groo030/DGIST-internship-2026/python/requirements-haptic.txt

pyserial>=3.5
bleak
bleak-retry-connector
anthropic
python-dotenv
Pillow
numpy
