groo030/DGIST-internship-2026/housing/housing_peltier_30_closure2_v1.stl

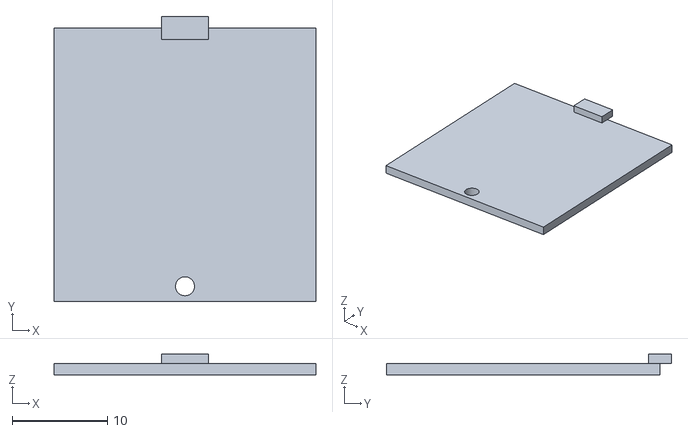
[picture p1: CAD file, 2026-10-23]
housing/housing_peltier_30_closure2_v1.stl
27.6 x 30.0 x 2.20
