groo030/DGIST-internship-2026/housing/housing_peltier_30_box_v1.stl

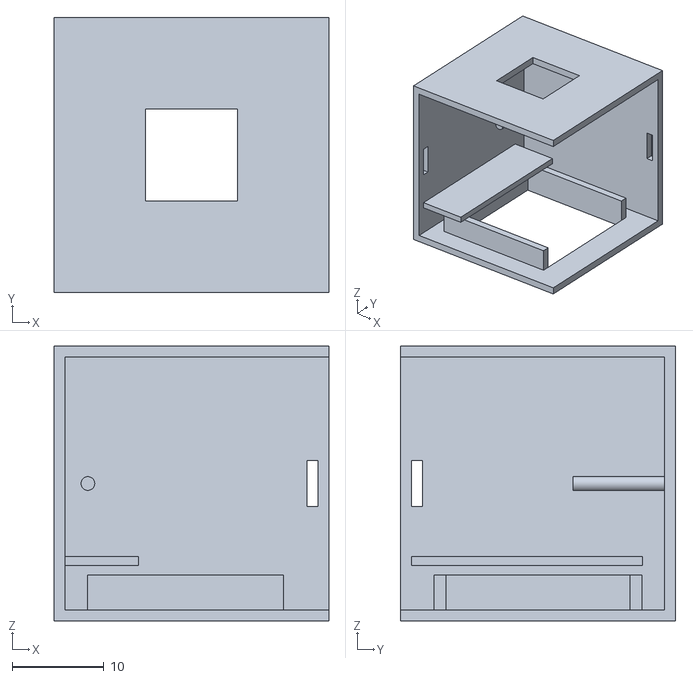
[picture p2: CAD file, 2026-10-23]
housing/housing_peltier_30_box_v1.stl
30.0 x 30.0 x 30.0
