groo030/DGIST-internship-2026/housing/housing_peltier_30_closure1_v1.stl

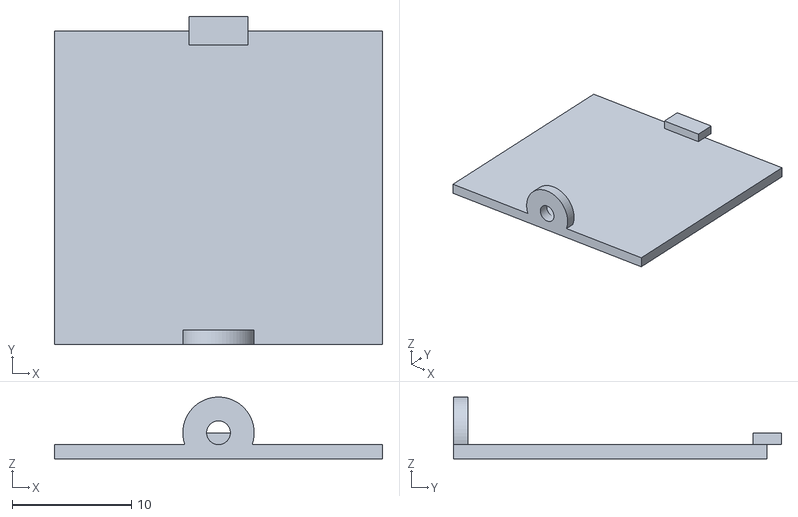
[picture p3: CAD file, 2026-10-23]
housing/housing_peltier_30_closure1_v1.stl
27.6 x 27.6 x 5.20
