groo030/DGIST-internship-2026/housing/housing_erm_box_v2.stl

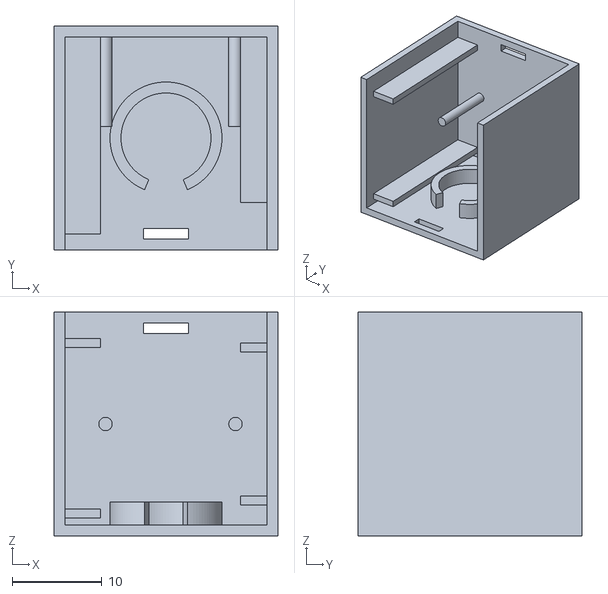
[picture p4: CAD file, 2026-10-23]
housing/housing_erm_box_v2.stl
25.0 x 25.0 x 25.0
