groo030/DGIST-internship-2026/housing/housing_erm_closure1_v2.stl

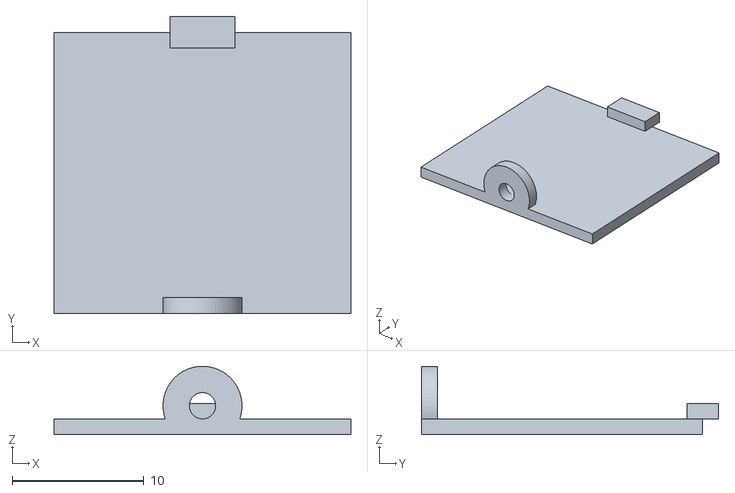
[picture p5: CAD file, 2026-10-23]
housing/housing_erm_closure1_v2.stl
22.6 x 22.6 x 5.20
