groo030/DGIST-internship-2026/housing/housing_platform_v2.stl

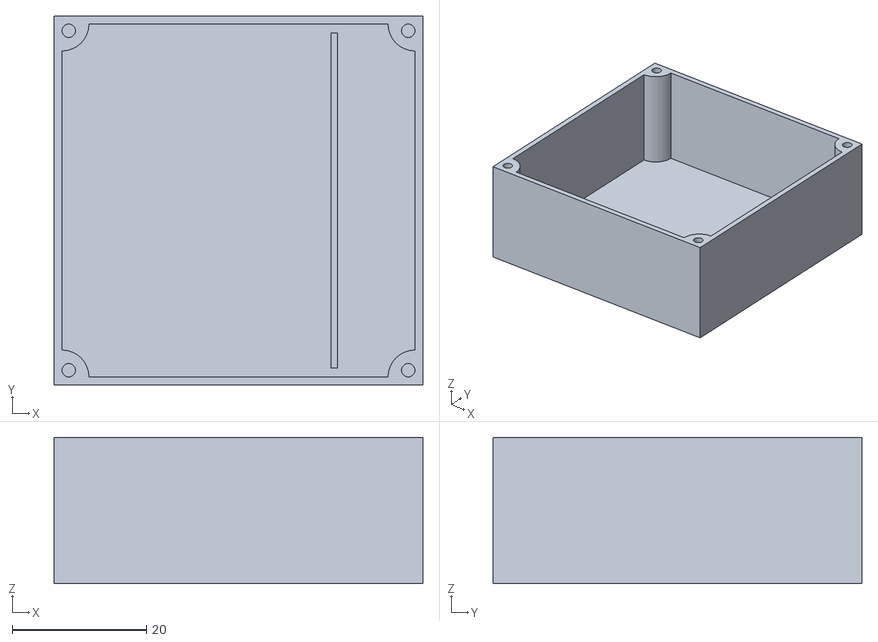
[picture p6: CAD file, 2026-10-23]
housing/housing_platform_v2.stl
55.0 x 55.0 x 21.8
