groo030/DGIST-internship-2026/housing/housing_erm_closure2_v2.stl

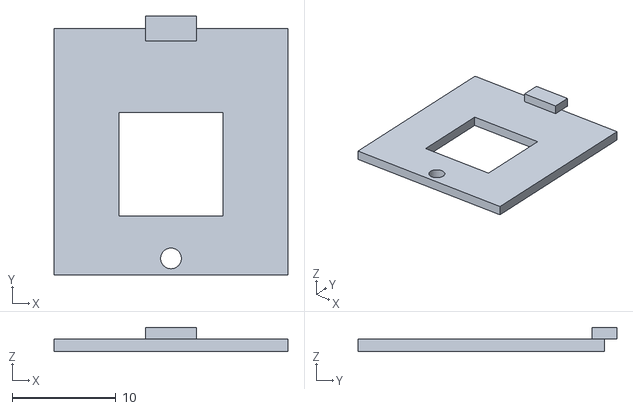
[picture p7: CAD file, 2026-10-23]
housing/housing_erm_closure2_v2.stl
22.6 x 25.0 x 2.32
