groo030/DGIST-internship-2026/housing/hat.3mf

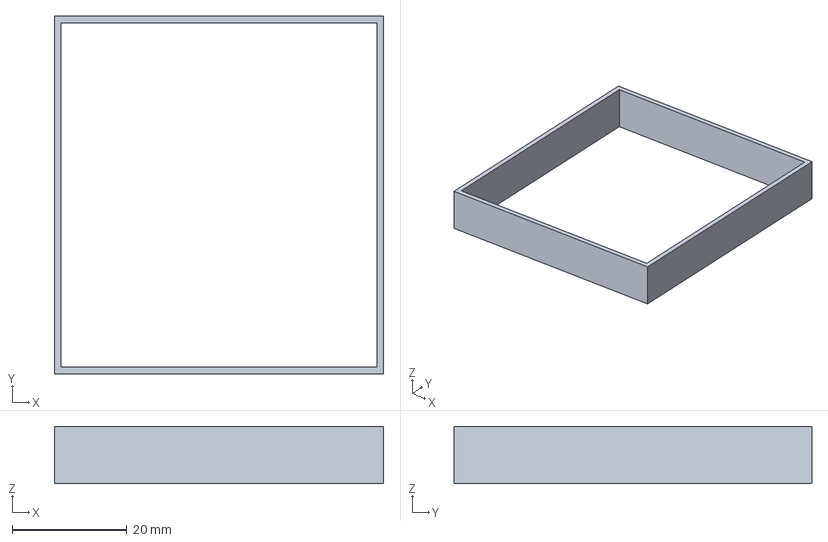
[picture p8: CAD file, 2026-10-23]
housing/hat.3mf
57.4 x 62.4 x 10.0 mm
