groo030/DGIST-internship-2026/(list of files, cad)

Other CAD files:
housing/housing_platform_v2_top.3mf
housing/housing_peltier_30_closure1_v1.scad
housing/housing_peltier_30_closure2_v1.scad
housing/hat.stl
housing/housing_platform_v2_top.stl
