groo030/DGIST-internship-2026/pcb/EMO.kicad_sch

## KiCad design pcb/EMO.kicad_sch (2026-10-23)

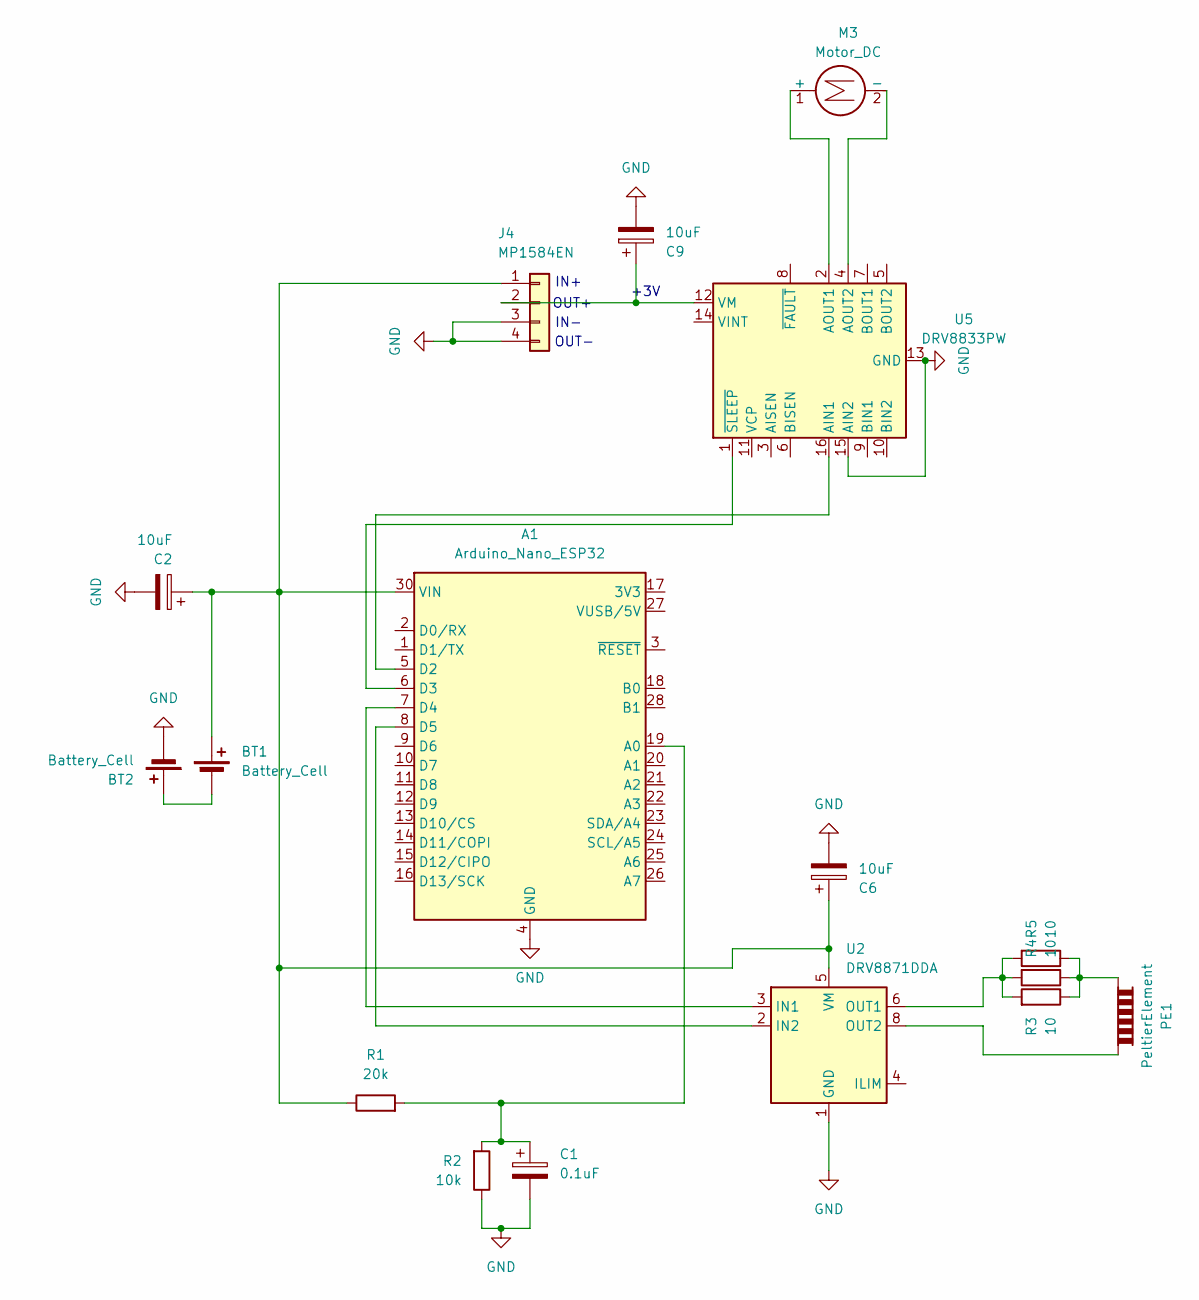
[picture p9: schematic EMO.kicad_sch]

Parts:
A1: Arduino_Nano_ESP32; Arduino_Nano
BT1, BT2: Battery_Cell
C1: 0.1uF
C2, C6, C9: 10uF
J4: MP1584EN
M3: Motor_DC
PE1: PeltierElement
R1: 20k
R2: 10k
R3, R4, R5: 10
U2: DRV8871DDA; Texas_HTSOP-8-1EP_3.9x4.9mm_P1.27mm_EP2.95x4.9mm_Mask2.4x3.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
U5: DRV8833PW; TSSOP-16_4.4x5mm_P0.65mm

Connections:
GND: A1.4 (GND), A1.29 (GND), BT2.2 (-), C1.2, C2.2, C6.2, C9.2, J4.3, J4.4, R2.1, U2.1 (GND), U2.7 (GND), U2.9 (GND), U5.13 (GND), U5.15 (AIN2)
unnamed: A1.5 (D2), U5.16 (AIN1)
unnamed: A1.6 (D3), U5.1 (~SLEEP)
unnamed: A1.7 (D4), U2.3 (IN1)
unnamed: A1.8 (D5), U2.2 (IN2)
unnamed: A1.19 (A0), C1.1, R1.2, R2.2
unnamed: A1.30 (VIN), BT1.1 (+), C2.1, C6.1, J4.1, R1.1, U2.5 (VM)
unnamed: BT1.2 (-), BT2.1 (+)
unnamed: C9.1, J4.2, U5.12 (VM)
unnamed: M3.1 (+), U5.2 (AOUT1)
unnamed: M3.2 (-), U5.4 (AOUT2)
unnamed: PE1.1, U2.8 (OUT2)
unnamed: PE1.2, R3.1, R4.1, R5.1
unnamed: R3.2, R4.2, R5.2, U2.6 (OUT1)

Notes on the sheet:
IN-
OUT+
IN+
+3V
OUT-
