groo030/DGIST-internship-2026/(commit log)

2026-10-23 Add DGIST 2026 internship project: EMO emotion expression with haptics
    [EMO.kicad_sch, EMO.scad, hard.3mf, hard.scad, hard.stl, hat.3mf, hat.scad, hat.stl]
2026-10-23 Keep only final housing designs
    [EMO.scad, housing.scad, housing_STL.stl, housing_box.scad, housing_box.stl, housing_closure.3mf, housing_closure.scad, housing_closure.stl]
2026-10-23 Remove housing preview images and hard
    [hard.3mf, hard.scad, hard.stl]
